WenGong-0514/Music_box_punching_machine/材料清单.xlsx

名称 | 数量 | 链接
3D模型 | 1 | 附件中"打印.3mf"
608ZZ轴承 | 3 | 同拓扭扭车三轮车滑板车轮子轴承童车608zz配件溜冰轮滑旱冰鞋-淘宝网 (https://item.taobao.com/item.htm?abbucket=0&id=584158922101&ns=1&skuId=4108745135651&xxc=taobaoSearch)
KFL08卧式支撑座 | 3 | 3D打印机配件 卧式梯形丝杆支架支撑座 T8丝杆立式支架KFL08 001-淘宝网 (https://item.taobao.com/item.htm?id=560724910124)
2GT同步轮20齿内孔8高16 | 2 | 3D打印机同步轮2GT gt2高品质外贸出口黑色同步带轮传动轮16/20齿-淘宝网 (https://item.taobao.com/item.htm?id=577469956078)
LM8uu直线轴承 内8外15高24 | 5 | LM6 8 10 12 16 20UU直线轴承 3d打印机加长光轴运动滑动电镀轴承-淘宝网 (https://item.taobao.com/item.htm?id=559466762255)
GT2-232mm同步带 | 1 | 3D打印机2GT环形闭口闭环同步带 橡胶传动皮带gt2 周长110-1220mm-淘宝网 (https://item.taobao.com/item.htm?id=559905551526)
镀镍碳钢挤出机弹簧 | 2 | 3d打印机弹簧配件 UM2 Z轴 CR10调平弹簧热床打印 挤出机压力弹簧-淘宝网 (https://item.taobao.com/item.htm?id=633984850729)
200mmT8丝杆 导程8 | 1 | 3D打印机丝杆 T8型梯形丝杆 304不锈钢全牙步进电机丝杠螺母导程8-淘宝网 (https://item.taobao.com/item.htm?id=559693268692)
200mm42丝杆步进电机 导程8 XH4P线 | 2 | 42直线丝杆步进电机 T8丝杆1.8°两相步进马达T型丝杆3D打印丝杆-淘宝网 (https://item.taobao.com/item.htm?id=575194131240)
50mm42丝杆步进电机 导程8 XH4P线 | 1 | 42直线丝杆步进电机 T8丝杆1.8°两相步进马达T型丝杆3D打印丝杆-淘宝网 (https://item.taobao.com/item.htm?id=575194131240)
CMS3驱动主板 | 1 | 大鱼diy grbl主板 蓝牙主板 GRBL主板 写字机器人主板-淘宝网 (https://item.taobao.com/item.htm?id=557787821873)
12V2A电源 | 1 | 大鱼diy grbl主板 蓝牙主板 GRBL主板 写字机器人主板-淘宝网 (https://item.taobao.com/item.htm?id=557787821873)
M3*50+6铜柱 | 4 | 螺柱六角螺柱单头六角铁柱镀镍隔离柱铜柱铜螺柱M3M2M2.5M4M5M6M8-淘宝网 (https://item.taobao.com/item.htm?id=619362746986)
M5*15螺丝 | 6 | M3M4M5M6M8M10M12M16 304不锈钢内六角螺丝钉加长圆柱头杯头螺栓-淘宝网 (https://item.taobao.com/item.htm?id=39202731013)
M5*10螺丝 | 6 | M3M4M5M6M8M10M12M16 304不锈钢内六角螺丝钉加长圆柱头杯头螺栓-淘宝网 (https://item.taobao.com/item.htm?id=39202731013)
M3*10螺丝 | 若干(50个以内) | M3M4M5M6M8M10M12M16 304不锈钢内六角螺丝钉加长圆柱头杯头螺栓-淘宝网 (https://item.taobao.com/item.htm?id=39202731013&skuId=5055372255060)
M3*15螺丝 | 若干(50个以内) | M3M4M5M6M8M10M12M16 304不锈钢内六角螺丝钉加长圆柱头杯头螺栓-淘宝网 (https://item.taobao.com/item.htm?id=39202731013&skuId=5055372255060)
2.0mm冲头 | 1 | 不锈钢打孔钳刀头东嘉原装打孔钳冲针金属发光字打孔钳针头冲套-淘宝网 (https://item.taobao.com/item.htm?id=585616603838)
硅胶软管 GJ-32 20*8mm | 1 | 硅胶密实圆管耐高温O型密封条定制软硅胶插入式O型密封圈圆柱胶套-淘宝网 (https://item.taobao.com/item.htm?id=675122001903)
BACF-C2G1-P-D8-L178-M5-N5 | 1 | 实心导向轴 直杆型 两端内螺纹型 g6｜参数选型、CAD下载、在线采购 | 嘉立创FA (https://www.jlcfa.com/serial/1738137505061.html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)
BACF-C2G1-P-D8-L180-M5-N5 | 3 | 实心导向轴 直杆型 两端内螺纹型 g6｜参数选型、CAD下载、在线采购 | 嘉立创FA (https://www.jlcfa.com/serial/1738137505061.html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)
