WenGong-0514/Music_box_punching_machine/HardWare_Model/总装配.stp

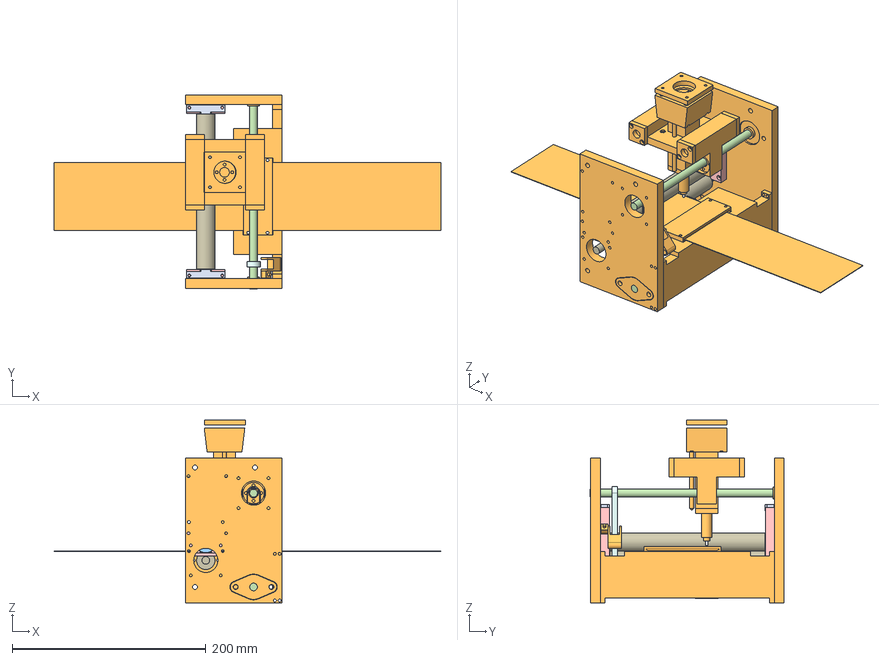
[picture p8: CAD file, 2026-09-22]
HardWare_Model/总装配.stp
400.0 x 200.8 x 189.0 mm
Z轴42电机固定架
冲头
冲头2
冲头3
运动平台
X轴张紧器
后挡板
纸带
KFL08_卧式梯形丝杆支架 x 3
T8丝杆简易模型_L200 x 2
GT2_232mm同步带简易模型
滚纸辗
滚纸辗2
Y轴滚纸辗滑槽 x 2
608zz x 3
Y轴从动辊张紧器 x 2
打孔支撑垫板
导向架
