WenGong-0514/Music_box_punching_machine/HardWare_Model/打印.3mf

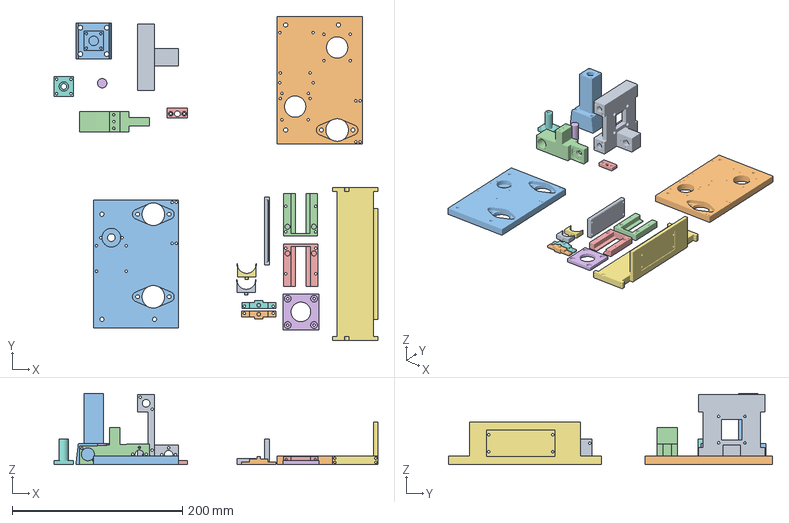
[picture p10: CAD file, 2026-09-22]
HardWare_Model/打印.3mf
380.8 x 381.0 x 83.5 mm
运动平台
后挡板
Y轴滚纸辗滑槽 x 2
Z轴42电机固定架
Y轴从动辊张紧器_1 x 2
Y轴从动辊张紧器_2 x 2
Admi467842A04loy_1
Admi467842A04loy_2
冲头滑块.stp_B
导向架_1
组合体
导向架_2
