WenGong-0514/Music_box_punching_machine/HardWare_Model/标准模型/42J1825-404-01（嘉立创jlcfa.com）.step

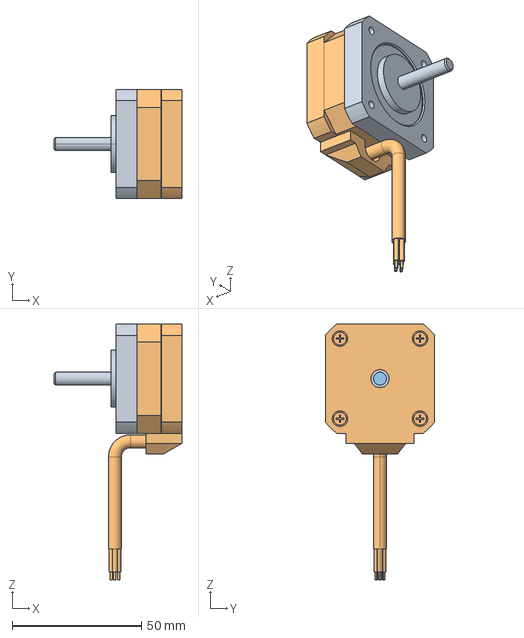
[picture p11: CAD file, 2026-09-14]
HardWare_Model/标准模型/42J1825-404-01（嘉立创jlcfa.com）.step
49.5 x 42.3 x 99.1 mm
