WenGong-0514/Music_box_punching_machine/HardWare_Model/标准模型/EJLC-M4-L50（嘉立创jlcfa.com）.step

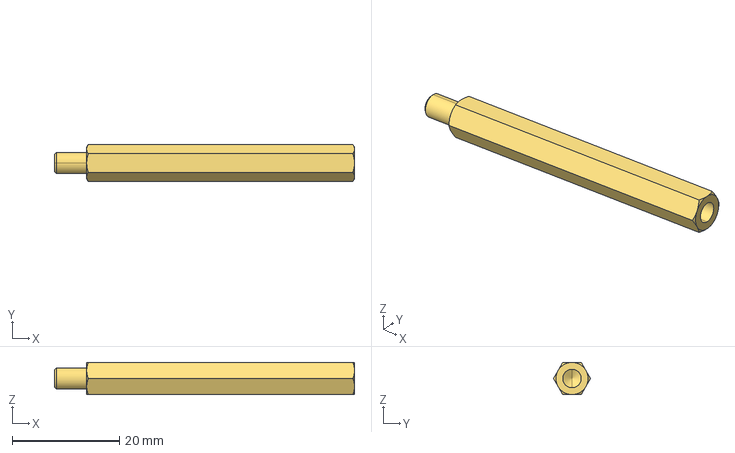
[picture p12: CAD file, 2026-09-14]
HardWare_Model/标准模型/EJLC-M4-L50（嘉立创jlcfa.com）.step
56.0 x 6.93 x 6.00 mm
