WenGong-0514/Music_box_punching_machine/HardWare_Model/标准模型/CBTH-A-S3M060-14-K-P-d6（嘉立创jlcfa.com）.step

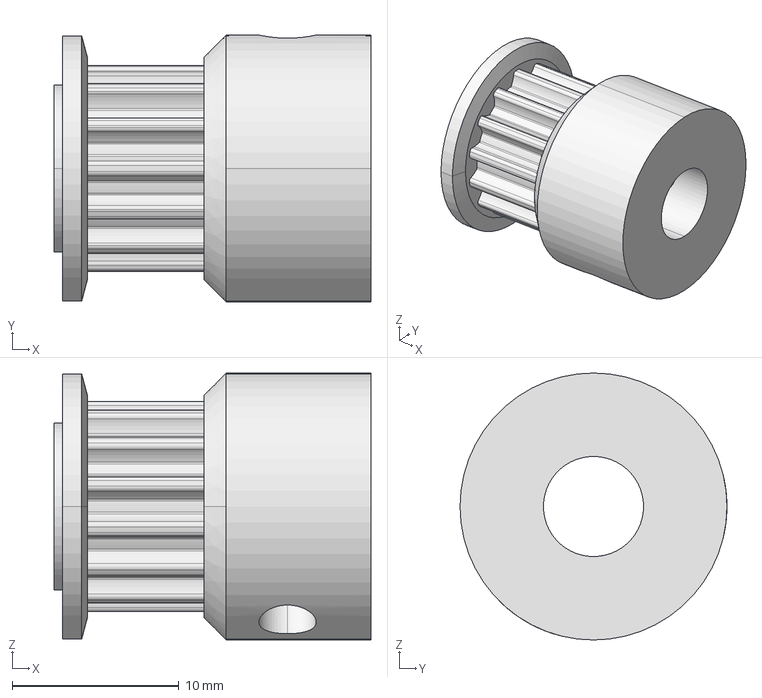
[picture p13: CAD file, 2026-09-14]
HardWare_Model/标准模型/CBTH-A-S3M060-14-K-P-d6（嘉立创jlcfa.com）.step
19.0 x 16.0 x 16.0 mm
