WenGong-0514/Music_box_punching_machine/HardWare_Model/标准模型/BACF-C2G1-P-D8-L200-M5-N5（嘉立创jlcfa.com）.step

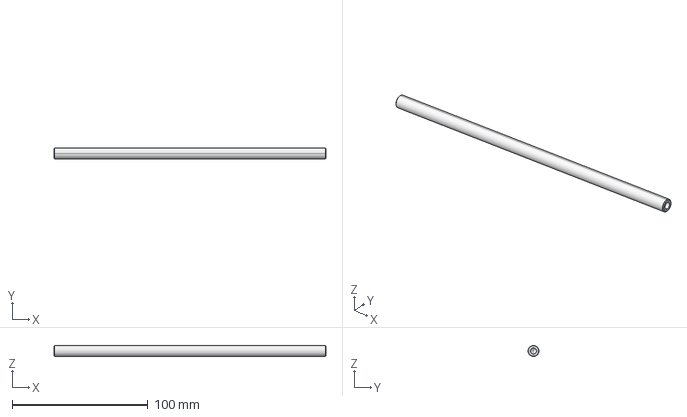
[picture p15: CAD file, 2026-09-14]
HardWare_Model/标准模型/BACF-C2G1-P-D8-L200-M5-N5（嘉立创jlcfa.com）.step
200.0 x 8.00 x 8.00 mm
