WenGong-0514/Music_box_punching_machine/(list of files, cad)

Other CAD files:
HardWare_Model/608zz.prt
HardWare_Model/D8光轴_200mm.prt
HardWare_Model/GT2_232mm同步带简易模型.prt
HardWare_Model/KFL08_卧式梯形丝杆支架.prt
HardWare_Model/T8丝杆简易模型_L200.prt
HardWare_Model/X轴张紧器.prt
HardWare_Model/X轴张紧器弹簧座.prt
HardWare_Model/Y轴从动辊张紧器.prt
HardWare_Model/Y轴滚纸辗滑槽.prt
HardWare_Model/Z轴42电机固定架.prt
HardWare_Model/冲头.prt
HardWare_Model/冲头2.prt
HardWare_Model/冲头3.prt
HardWare_Model/冲头滑块.prt
HardWare_Model/前挡板.prt
HardWare_Model/后挡板.prt
HardWare_Model/导向架.prt
HardWare_Model/总装配.prt
HardWare_Model/打孔支撑垫板.prt
HardWare_Model/标准模型/1000.prt
HardWare_Model/标准模型/42J1825-404-01（嘉立创jlcfa.com）.prt
HardWare_Model/标准模型/42J1848-425_ASM.prt
HardWare_Model/标准模型/BACF-C2G1-P-D8-L180-M5-N5（嘉立创jlcfa.com）_step.prt
HardWare_Model/标准模型/BACF-C2G1-P-D8-L190-M5-N5（嘉立创jlcfa.com）_step.prt
HardWare_Model/标准模型/BACF-C2G1-P-D8-L200-M5-N5（嘉立创jlcfa.com）_step.prt
HardWare_Model/标准模型/CBTH-A-S3M060-14-K-P-d6（嘉立创jlcfa.com）_step.prt
HardWare_Model/标准模型/EJLC-M4-L50（嘉立创jlcfa.com）_step.prt
HardWare_Model/标准模型/NONE.prt
HardWare_Model/滚纸辗.prt
HardWare_Model/滚纸辗2.prt
HardWare_Model/纸带.prt
HardWare_Model/辊子限位.prt
HardWare_Model/运动平台.prt
