WenGong-0514/Music_box_punching_machine/(commit log)

2026-09-14 Initial commit: MusicBox Tape Studio (30-note music box tape punch host)
    - FastAPI backend + vanilla-JS frontend (local web app on 127.0.0.1:8765)
    - Engines: Basic Pitch (ONNX), DSP fallback, Omnizart via pluggable HTTP engine service
    - MIDI score import: pick instrument tracks -> notes -> tape (no audio guessing)
    - Quantizer: auto-transpose, conflict-aware octave folding, ghost suppression, register filter
    - Tape editor + exports: JSON/CSV/SVG/PNG/MIDI/G-code (GRBL punch, verified machine params)
    - Docs: docs/DEVELOPMENT.md, docs/MACHINE.md, docs/ENGINES.md, docs/HISTORY.md
    - License: GPL-3.0 (third-party notices in THIRD_PARTY.md)
2026-09-14 Add hardware CAD models and sources; docs/HARDWARE.md; GPL notice in UI
    - HardWare_Model/: Creo parts (punch, slider, guides, rollers, frame), 3MF print plates, JLC standard parts
    - docs/HARDWARE.md: hardware composition, external sources (CMS3 controller, GRBL-Plotter,
    MakerWorld parametric spring generator, JLC standard parts), license notes, metadata cleanup advice
    - THIRD_PARTY.md: hardware/tool sources + NC-vs-GPL license caveat
    - .gitignore: exclude CAE export logs (contain third-party author name and local paths)
    - .gitattributes: line-ending & binary handling
    - web/index.html: GPL-3.0 copyright/no-warranty notice in footer
    [1000.prt, 42J1825-404-01（嘉立创jlcfa.com）.prt, 42J1825-404-01（嘉立创jlcfa.com）.step, 42J1848-425_ASM.prt, 608zz.prt, BACF-C2G1-P-D8-L180-M5-N5（嘉立创jlcfa.com）.step, BACF-C2G1-P-D8-L180-M5-N5（嘉立创jlcfa.com）_step.prt, BACF-C2G1-P-D8-L190-M5-N5（嘉立创jlcfa.com）.step]
2026-09-14 Remove 3MF print plate from repo (license compliance)
    The print plate may contain geometry produced by a third-party model generator
    (MakerWorld 'parametric compression spring generator'), whose Standard Digital File
    License forbids redistributing/hosting its digital or 3D-printed versions and
    derivatives, regardless of whether distribution is free. Its digital files are
    therefore not distributed with this repository; only attribution/source notes remain.
    - .gitignore: exclude HardWare_Model/*.3mf by default
    - docs/HARDWARE.md: document the license terms, compliance points and alternatives
    - THIRD_PARTY.md / README.md: state explicitly that spring model files are not distributed
    [打印.3mf]
2026-09-16 docs+hardware: 更新上位机与机构设计,Omnizart 权重随仓库分发
    - .gitignore: 显式保留 third_party/omnizart/checkpoints(约 90MB 模型权重),
    避免被通用 *.tar / 大文件规则误伤;其余大体积运行时数据继续排除。
    - HardWare_Model: 补充总装配 STEP 导出,更新总装配 PRT。
    - server/tape.py, server/gcode.py: 纸带与 G-code 生成调整。
    - tools/make_preflight_gcode.py: 预检 G-code 输出调整。
    - web/js/app.js: 前端交互调整。
    - docs/MACHINE.md, README.md: 文档同步。
    - 材料清单.xlsx: 补入物料清单。
    [总装配.prt, 总装配.stp, 材料清单.xlsx]
2026-09-16 README: 顶部增加 AI 生成声明、侵权联系与免责声明
    - 在标题下方加醒目提示块: 电脑端代码由 AI 生成、未经人工审核。
    - 增加侵权联系删除说明(联系方式 stm32f103@qq.com)。
    - 增加免责声明小节, 并把警示落到本项目实际风险: 生成的 G-code 会驱动物理
    冲压机构, 需先空跑验证行程与安全高度后再上机。
2026-09-16 README: 顶部增加 GitHub 仓库链接与徽章, 并新增"附件与大型文件获取方式"
    项目同时发布在 GitHub 与 OSHWHub, OSHWHub 无法上传大型附件, 故:
    - 顶部醒目位置给出仓库地址 + GitHub/GPL-3.0/平台 三个徽章。
    - 新增「📦 附件与大型文件获取方式」小节, 以表格逐项说明每类内容
    (源码/模型权重/CAD/1GB 引擎镜像/生成物/版权内容)的体积与获取方式,
    并说明两项平台注意事项: 大文件以 GitHub 为准; 克隆取大文件而非 raw 直链。
    - 体积数据均实测: 仓库约 100 MB(权重 89 MB, 源码+文档+CAD 约 11 MB),
    basic_pitch wheel 0.72 MB(修正原先误写的 ~30 MB), 引擎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
2026-09-16 docs: 收录 GRBL 实机设置截图, 并记录与代码默认值的已知不一致
    - 图片从仓库根移到 docs/images/grbl-settings.png(原文件名含中文,
    在 URL/markdown 渲染中会变成百分号编码, 易出兼容问题)。
    - README「硬件:打孔机与 G-code」新增「GRBL 实机设置」小节: 嵌图 +
    三轴关键值速查表(steps/mm / 最大速率 / 加速度)。
    - docs/MACHINE.md §7 重写为「建议值 vs 本机实测值」: 逐轴对照表 + 其余
    $ 参数说明, 并新增两节:
    * 7.2 xy_feed(代码默认 3000)超过本机 $110/$111 上限 2500 ——
    GRBL 会自行限速故不会出错, 但注释里的 X 空移耗时低估约 17%;
    同时标注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
2026-09-18 feat(gui): 打孔 Z 三层提为可选参数(⑤), 并补充重启后恢复会话
    ## 打孔 Z 三层(主要改动)
    Z 由"两个半参数"改为三个语义明确的正式参数, 且可在 GUI 里改、存进工程:
    - `z_travel`(移动高度, 默认 0): 完全不冲孔时的高度 —— G00 首尾定位、尾部外送带
    - `z_safe`(安全高度, 默认 4): 冲孔后抬起位; 打孔阶段所有移动(行内横移 + 换行送带)都在此
    - `z_work`(工作高度, 默认 10): 冲孔位
    原来的 `z_home` / `move_z` 退为只读别名(指向 `z_travel` / `z_safe`), 旧调用不会失效;
    `z_stroke_mm` 改为 `|z_work - z_safe|`, 默认仍是 6mm, 输出与旧版等价。
    新增 `validate_z()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
    [导向架.prt]
2026-09-21 docs+feat: 收录界面运行效果图, 修复中文文件名与下载名, 尾部外送改 100mm
    ## 界面运行效果图
    - 新增 `docs/images/ui-preview.png`(1893x1782), README「界面流程」新增
    「运行效果」小节嵌图, 并说明画面构成。
    - 目录结构一栏同步。
    ## 中文文件名与下载(server/api.py)
    - 上传: `x-file-name` 用 RFC 3986 解码(`unquote`)—— 前端以 encodeURIComponent
    传中文名, 旧代码直接当原始名用, 中文会变成 `%E6%9F%90...` 脏文件名。
    - 下载: `Content-Disposition` 按 RFC 6266 同时给出纯 ASCII 回退名与
    `filename*=UTF-8''...`, 兼顾现代浏览器与只看 `filename=` 的老客户端。
    - 兼容旧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
    [导向架.prt, 总装配.prt, 总装配.stp]
2026-09-21 docs+hardware: 弹簧改为"自己生成+合装"教程并入库打印盘, 3mf 已剔除第三方件
    ## 打印盘入库(HardWare_Model/打印.3mf)
    作者已在 BambuStudio 中把 MakerWorld 生成的压纸弹簧从盘上删除, 现逐件核对
    **17 个零件全部为作者自绘**(source_file 均指向本地 冲头滑块.stp / 打印.3mf),
    不再含任何第三方模型:
    - 原先那个由 MakerWorld 下载件引入的零件(名称/来源为
    `MTBjNTUyMmEt...` 的 base64 工程 UUID, 解出 MakerWorld 设计 UUID +
    用户 ID 1486360542)已不在包内;
    - 其余稠密网格仅剩 object_107(8507 顶点, 普通机械件), 原先 14k 顶点的
    螺旋件已消失。
    因此许可障碍解除,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
    [打印.3mf]
2026-09-21 docs: 新增「纸带」选型与用量一节, 并校正 MACHINE.md 与当前工程不符的实测数据
    ## 新增:纸带选型与用量(README 新小节 + HARDWARE.md)
    - README 新增「## 纸带:选什么、买多少」, 含三部分:
    * **机器打孔不需要网格纸带** —— 市售"30 音纸带"是给手工打孔用的(印网格靠人眼对齐),
    本机孔位完全由坐标算出(X 由列公式、Y 由时间步), 网格对本机没有用处还更贵。
    * **为什么买长的** —— 给出用量公式与对照表: 纸带长度只由曲目时长决定
    (与 BPM/每拍格数无关), `长度 = 时长 × feed_mm_s`, 默认 16 mm/s ⇒ 每分钟音乐约 0.96m;
    故 30 秒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
2026-09-21 docs: 纠正纸带用量公式(BPM 会影响用量), 更新纸带图片
    ## 纠正:纸带长度并非只由时长决定
    原写法(README 与 MACHINE.md)称"纸带消耗量只由曲目时长决定(与 BPM、每拍格数无关)",
    **这是错的**。作者指出实际关系:
    - `每步孔距 mm_per_step = (60 / (BPM × 每拍格数)) × feed_mm_s`
    - **BPM 越高 ⇒ 孔距越密**;密到音梳来不及复位(来不及重新拨响)时,必须把 **Y 轴按比例拉伸 k 倍**;
    - 拉伸后孔更疏、按原速放会变慢,于是**再把八音盒本身走带速度调快同样的比例**,声音时长才不变。
    ⇒ 正确公式:`纸带长度 = 时长 × feed_mm_s × k`(k = Y 拉伸系数;k=1 时才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
2026-09-22 hardware: 更新总装配/导向架/打印盘, 修复导向架纸带入口余量不足
    ## 改动
    作者修正了 **导向架对纸带宽度的预留余量不足**导致纸带难以正常进入导向架的问题,
    并同步更新了受影响的装配体与打印排版:
    - `HardWare_Model/导向架.prt`(修正件本体)
    - `HardWare_Model/总装配.prt`(装配随之更新)
    - `HardWare_Model/打印.3mf`(打印盘按新件重新导出;17 个零件)
    ## 入库前核对(打印盘含第三方件的既往教训)
    逐件核对 `打印.3mf` 的 `Metadata/model_settings.config`:
    - 17 个零件,`source_file` 全部指向作者本地 CAD(`冲头滑块.3mf` / `冲头滑块.stp` / `打印.3mf`);
    - **不含**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
    [导向架.prt, 总装配.prt, 打印.3mf]
2026-09-22 hardware: 补上总装配的 STEP 导出(随导向架修正同步)
    上一次提交更新了 `总装配.prt` / `导向架.prt` / `打印.3mf`, 但漏了重新导出
    `总装配.stp`, 导致只能打开 STEP 的人拿到的仍是纸带入口余量不足的旧装配。
    本次补上该导出(749881 → 749940 字节), 三件套现已同步。
    > 提醒:`docs/HARDWARE.md` §2 说明 `.prt` 是 Creo 专有格式、未装 Creo 的人打不开,
    > 因此建议每次改装配体后都同步导出 STEP。
    [总装配.stp]
